HarisSuhail/TurMet/Src/main.c

/**
  ******************************************************************************
  * File Name          : main.c
  * Description        : Main program body
  ******************************************************************************
  *
  * COPYRIGHT(c) 2015 STMicroelectronics
  *
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
  ******************************************************************************
  */
/* Includes ------------------------------------------------------------------*/
#include "stm32f1xx_hal.h"
#include "adc.h"
#include "iwdg.h"
#include "usart.h"
#include "gpio.h"
#include <string.h>


/* USER CODE BEGIN Includes */
#include "C:\Users\Impulse\Documents\TurMet\MDK-ARM\globalvariables.h"
/* USER CODE END Includes */


/* USER CODE BEGIN PV */

/* USER CODE END PV */

void SystemClock_Config(void);

/* USER CODE BEGIN PFP */

/* USER CODE END PFP */

/* USER CODE BEGIN 0 */
void sendLog(uint8_t* message)
{
	HAL_UART_Transmit(&huart2, message, strlen(message), 10);
}

void sendBT(uint8_t* message)
{
	HAL_UART_Transmit(&huart1, message, strlen(message), 10);
}

char *itoa(int i)
{
  static char buffer[12];

  if (snprintf(buffer, sizeof(buffer), "%d", i) < 0)
    return NULL;

  return buffer;
}

/* USER CODE END 0 */

int main(void)
{

	
  /* USER CODE BEGIN 1 */
	//																					---INITIALIZING GLOBAL VARIABLES---
																									
																									 
	unsigned char messageBuffer[10] = {0};													
  /* USER CODE END 1 */

  /* MCU Configuration----------------------------------------------------------*/

  /* Reset of all peripherals, Initializes the Flash interface and the Systick. */
  HAL_Init();

  /* Configure the system clock */
  SystemClock_Config();

  /* Initialize all configured peripherals */
  MX_GPIO_Init();
  MX_ADC1_Init();
  MX_ADC2_Init();
  MX_IWDG_Init();
  MX_USART1_UART_Init();
  MX_USART2_UART_Init();

	sendLog("Ready\r\n");
	sendBT("Ready\r\n");
  /* USER CODE BEGIN 2 */
	//																									---ENABLING ADC , USART AND WATCHDOG---
	HAL_ADC_Start_IT(&hadc1);
	HAL_ADC_Start_IT(&hadc2);
	HAL_UART_Receive_IT(&huart1, messageBuffer, 10);
	HAL_IWDG_Start(&hiwdg);
	
																										
  /* USER CODE END 2 */
	sendLog("ADC activated\r\n");
  /* Infinite loop */
  /* USER CODE BEGIN WHILE */
  while (1)
  {
		
		HAL_IWDG_Refresh(&hiwdg);
		HAL_Delay(200);
		HAL_IWDG_Refresh(&hiwdg);
		HAL_Delay(200);
		HAL_ADC_Stop_IT(&hadc1);
		HAL_ADC_Stop_IT(&hadc2);
  /* USER CODE END WHILE */
	
	
  /* USER CODE BEGIN 3 */
		HAL_IWDG_Refresh(&hiwdg);
		while(!activated)
		{
			HAL_IWDG_Refresh(&hiwdg);
			HAL_Delay(10);
		}
		sendLog("A -> ");
		sendLog(itoa(averageA()));
		sendLog(" B -> ");
		sendLog(itoa(averageB()));
		sendLog("       \r\n");
		HAL_IWDG_Refresh(&hiwdg);
		sendBT("A -> ");
		sendBT(itoa(averageA()));
		sendBT(" B -> ");
		sendBT(itoa(averageB()));
		sendBT("       \r\n");
		
		HAL_IWDG_Refresh(&hiwdg);
		HAL_ADC_Start_IT(&hadc1);
		HAL_ADC_Start_IT(&hadc2);
		

  }
  /* USER CODE END 3 */

}

/** System Clock Configuration
*/
void SystemClock_Config(void)
{

  RCC_OscInitTypeDef RCC_OscInitStruct;
  RCC_ClkInitTypeDef RCC_ClkInitStruct;
  RCC_PeriphCLKInitTypeDef PeriphClkInit;

  RCC_OscInitStruct.OscillatorType = RCC_OSCILLATORTYPE_HSI|RCC_OSCILLATORTYPE_LSI;
  RCC_OscInitStruct.HSIState = RCC_HSI_ON;
  RCC_OscInitStruct.HSICalibrationValue = 16;
  RCC_OscInitStruct.LSIState = RCC_LSI_ON;
  RCC_OscInitStruct.PLL.PLLState = RCC_PLL_ON;
  RCC_OscInitStruct.PLL.PLLSource = RCC_PLLSOURCE_HSI_DIV2;
  RCC_OscInitStruct.PLL.PLLMUL = RCC_PLL_MUL16;
  HAL_RCC_OscConfig(&RCC_OscInitStruct);

  RCC_ClkInitStruct.ClockType = RCC_CLOCKTYPE_SYSCLK|RCC_CLOCKTYPE_PCLK1
                              |RCC_CLOCKTYPE_PCLK2;
  RCC_ClkInitStruct.SYSCLKSource = RCC_SYSCLKSOURCE_PLLCLK;
  RCC_ClkInitStruct.AHBCLKDivider = RCC_SYSCLK_DIV1;
  RCC_ClkInitStruct.APB1CLKDivider = RCC_HCLK_DIV2;
  RCC_ClkInitStruct.APB2CLKDivider = RCC_HCLK_DIV8;
  HAL_RCC_ClockConfig(&RCC_ClkInitStruct, FLASH_LATENCY_2);

  PeriphClkInit.PeriphClockSelection = RCC_PERIPHCLK_ADC;
  PeriphClkInit.AdcClockSelection = RCC_ADCPCLK2_DIV2;
  HAL_RCCEx_PeriphCLKConfig(&PeriphClkInit);

  HAL_SYSTICK_Config(HAL_RCC_GetHCLKFreq()/1000);

  HAL_SYSTICK_CLKSourceConfig(SYSTICK_CLKSOURCE_HCLK);

  /* SysTick_IRQn interrupt configuration */
  HAL_NVIC_SetPriority(SysTick_IRQn, 0, 0);
}

#ifdef USE_FULL_ASSERT

/**
   * @brief Reports the name of the source file and the source line number
   * where the assert_param error has occurred.
   * @param file: pointer to the source file name
   * @param line: assert_param error line source number
   * @retval None
   */
void assert_failed(uint8_t* file, uint32_t line)
{
  /* USER CODE BEGIN 6 */
  /* User can add his own implementation to report the file name and line number,
    ex: printf("Wrong parameters value: file %s on line %d\r\n", file, line) */
  /* USER CODE END 6 */

}

#endif

/**
  * @}
  */ 

/**
  * @}
*/ 

/************************ (C) COPYRIGHT STMicroelectronics *****END OF FILE****/
