HarisSuhail/TurMet/Src/adc.c

/**
  ******************************************************************************
  * File Name          : ADC.c
  * Description        : This file provides code for the configuration
  *                      of the ADC instances.
  ******************************************************************************
  *
  * COPYRIGHT(c) 2015 STMicroelectronics
  *
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
  ******************************************************************************
  */

/* Includes ------------------------------------------------------------------*/
#include "adc.h"

#include "gpio.h"

ADC_HandleTypeDef hadc1;
ADC_HandleTypeDef hadc2;

/* ADC1 init function */
void MX_ADC1_Init(void)
{
  ADC_ChannelConfTypeDef sConfig;

    /**Common config 
    */
  hadc1.Instance = ADC1;
  hadc1.Init.ScanConvMode = ADC_SCAN_DISABLE;
  hadc1.Init.ContinuousConvMode = ENABLE;
  hadc1.Init.DiscontinuousConvMode = DISABLE;
  hadc1.Init.ExternalTrigConv = ADC_SOFTWARE_START;
  hadc1.Init.DataAlign = ADC_DATAALIGN_RIGHT;
  hadc1.Init.NbrOfConversion = 1;
  HAL_ADC_Init(&hadc1);

    /**Configure Regular Channel 
    */
  sConfig.Channel = ADC_CHANNEL_0;
  sConfig.Rank = 1;
  sConfig.SamplingTime = ADC_SAMPLETIME_239CYCLES_5;
  HAL_ADC_ConfigChannel(&hadc1, &sConfig);

}
/* ADC2 init function */
void MX_ADC2_Init(void)
{
  ADC_ChannelConfTypeDef sConfig;

    /**Common config 
    */
  hadc2.Instance = ADC2;
  hadc2.Init.ScanConvMode = ADC_SCAN_DISABLE;
  hadc2.Init.ContinuousConvMode = ENABLE;
  hadc2.Init.DiscontinuousConvMode = DISABLE;
  hadc2.Init.ExternalTrigConv = ADC_SOFTWARE_START;
  hadc2.Init.DataAlign = ADC_DATAALIGN_RIGHT;
  hadc2.Init.NbrOfConversion = 1;
  HAL_ADC_Init(&hadc2);

    /**Configure Regular Channel 
    */
  sConfig.Channel = ADC_CHANNEL_1;
  sConfig.Rank = 1;
  sConfig.SamplingTime = ADC_SAMPLETIME_239CYCLES_5;
  HAL_ADC_ConfigChannel(&hadc2, &sConfig);

}

void HAL_ADC_MspInit(ADC_HandleTypeDef* hadc)
{

  GPIO_InitTypeDef GPIO_InitStruct;
  if(hadc->Instance==ADC1)
  {
    /* Peripheral clock enable */
    __ADC1_CLK_ENABLE();
  
    /**ADC1 GPIO Configuration    
    PA0-WKUP     ------> ADC1_IN0 
    */
    GPIO_InitStruct.Pin = GPIO_PIN_0;
    GPIO_InitStruct.Mode = GPIO_MODE_ANALOG;
    HAL_GPIO_Init(GPIOA, &GPIO_InitStruct);

    /* Peripheral interrupt init*/
    HAL_NVIC_SetPriority(ADC1_2_IRQn, 0, 0);
    HAL_NVIC_EnableIRQ(ADC1_2_IRQn);
  }
  else if(hadc->Instance==ADC2)
  {
    /* Peripheral clock enable */
    __ADC2_CLK_ENABLE();
  
    /**ADC2 GPIO Configuration    
    PA1     ------> ADC2_IN1 
    */
    GPIO_InitStruct.Pin = GPIO_PIN_1;
    GPIO_InitStruct.Mode = GPIO_MODE_ANALOG;
    HAL_GPIO_Init(GPIOA, &GPIO_InitStruct);

    /* Peripheral interrupt init*/
    HAL_NVIC_SetPriority(ADC1_2_IRQn, 0, 0);
    HAL_NVIC_EnableIRQ(ADC1_2_IRQn);
  }
}

void HAL_ADC_MspDeInit(ADC_HandleTypeDef* hadc)
{

  if(hadc->Instance==ADC1)
  {
    /* Peripheral clock disable */
    __ADC1_CLK_DISABLE();
  
    /**ADC1 GPIO Configuration    
    PA0-WKUP     ------> ADC1_IN0 
    */
    HAL_GPIO_DeInit(GPIOA, GPIO_PIN_0);

    /* Peripheral interrupt Deinit*/
  /* USER CODE BEGIN ADC1:ADC1_2_IRQn disable */
    /**
    * Uncomment the line below to disable the "ADC1_2_IRQn" interrupt
    * Be aware, disabling shared interrupt may affect other IPs
    */
    /* HAL_NVIC_DisableIRQ(ADC1_2_IRQn); */
  /* USER CODE END ADC1:ADC1_2_IRQn disable */

  }
  else if(hadc->Instance==ADC2)
  {
    /* Peripheral clock disable */
    __ADC2_CLK_DISABLE();
  
    /**ADC2 GPIO Configuration    
    PA1     ------> ADC2_IN1 
    */
    HAL_GPIO_DeInit(GPIOA, GPIO_PIN_1);

    /* Peripheral interrupt Deinit*/
  /* USER CODE BEGIN ADC2:ADC1_2_IRQn disable */
    /**
    * Uncomment the line below to disable the "ADC1_2_IRQn" interrupt
    * Be aware, disabling shared interrupt may affect other IPs
    */
    /* HAL_NVIC_DisableIRQ(ADC1_2_IRQn); */
  /* USER CODE END ADC2:ADC1_2_IRQn disable */

  }
} 

/**
  * @}
  */

/**
  * @}
  */

/************************ (C) COPYRIGHT STMicroelectronics *****END OF FILE****/
